hayoung610/Specilization3/labreport2_HayoungKim.pdf

JACOBS UNIVERSITY

# PCB design ECE Specialization Areas Lab Instructor: Uwe Pagel

## Hayoung Kim mailbox : KA-325

January 1, 2020

1

1 INTRODUCTION

In the lab, an insight of how an electronic device is actually designed was obtained. How the circuit is requested, specified, verified, PCB designed were studied by going through an example. The program LTspice, MATLAB were used to calculate and simulate the values of necessary components and to decide which components to use. Program KiCad was used to design the whole circuit. After deciding all the components and simulated, the PCB layout were set and designed.

2 REQUEST

Circuit which measures temperature and transmits the result as an I2C slave is required. Temperature range: −10o

to +50o
Voltage supply: 5V ±10% , USB, RS232 port
Accuracy: ±(5%r dg +4dg t)
Sample rate: 2Val/min
Stored history: Values last two hours
Environment: Resistance against condition inside normal office.
Other requirement such as weight, medium size, due date, costs needs to be considered.

3 SPECIFICATION

3.1 CIRCUIT DEFINITION

Circuit was divided into three functional blocks: Power, Analog, Digital Power : Power supply of +5V for analog and digital part
Analog : Sensor and Amplifier
Digital : Combined ADC and I2C

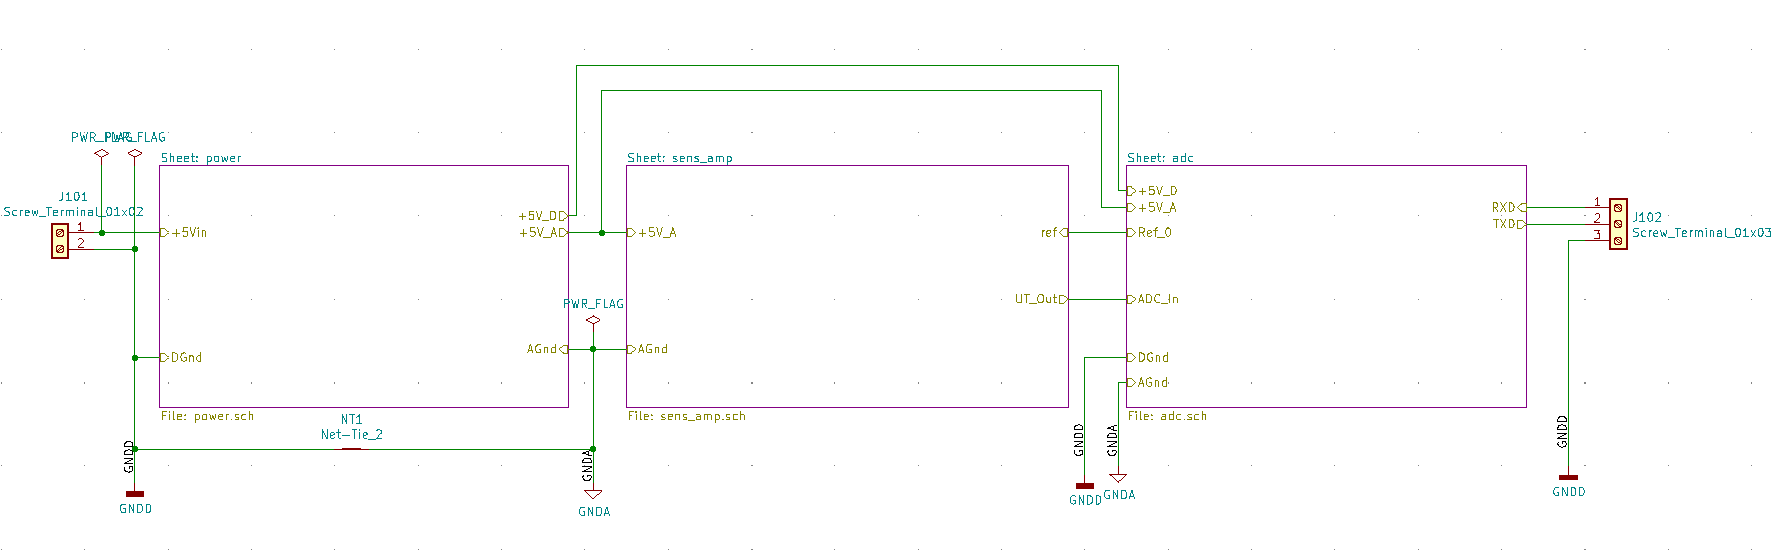
[picture p1: figure]

Figure 3.1: Circuit

2

3.2 DIGITAL PART

Digital part component : ADC, Timer, serial interface, memory
To contain all of the components, a micro controller is used. In the experiment, ATmega 328P was selected. ATmega328P includes 10 bit ADC. Which is enough to have one sample every 30 seconds(2Vals/min). However the error can be increased by 10 % but this is acceptable to reduce the cost.

The requested storage time says it has to store for two hours with sample rate of 2Val/min. With the calculation of 2Val/min*120min = 240 Vals need to be stored. Each values has 2 Bytes therefore total of 480bytes are needed. ATmega 328P has internal memory of 2048byte RAM that gives enough RAM for the program to run and store data.

The used micro controller has a reference voltage of 1.1V that can be used in the analog part for accurate measurement. In addition, it contains timer and RS232 interface. All the information of the micro controller can be checked in the datasheet of ATmega 328P. The digital part circuit is shown in figure 3.2.

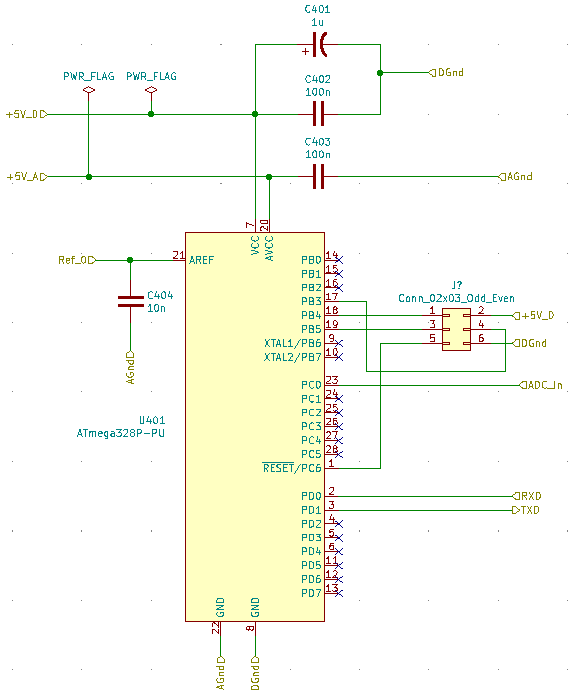
[picture p2: figure]

Figure 3.2: Digital part

3

3.3 ANALOG PART

Analog part components: Amplifiers, temperature sensor, reference voltage
The reference voltage comes from the micro controller from the digital part. This supply is too week because the output is less than 1mA. Therefore a non inverting amplifier is used. For the temperature sensor PT1000 is used in a Wheatstone bridge to sense the change in resistance. In addition, an instrumentation amplifier is used as a differential amplifier to amplify the output of the bridge circuit. The analog part circuit is shown in figure 3.3.

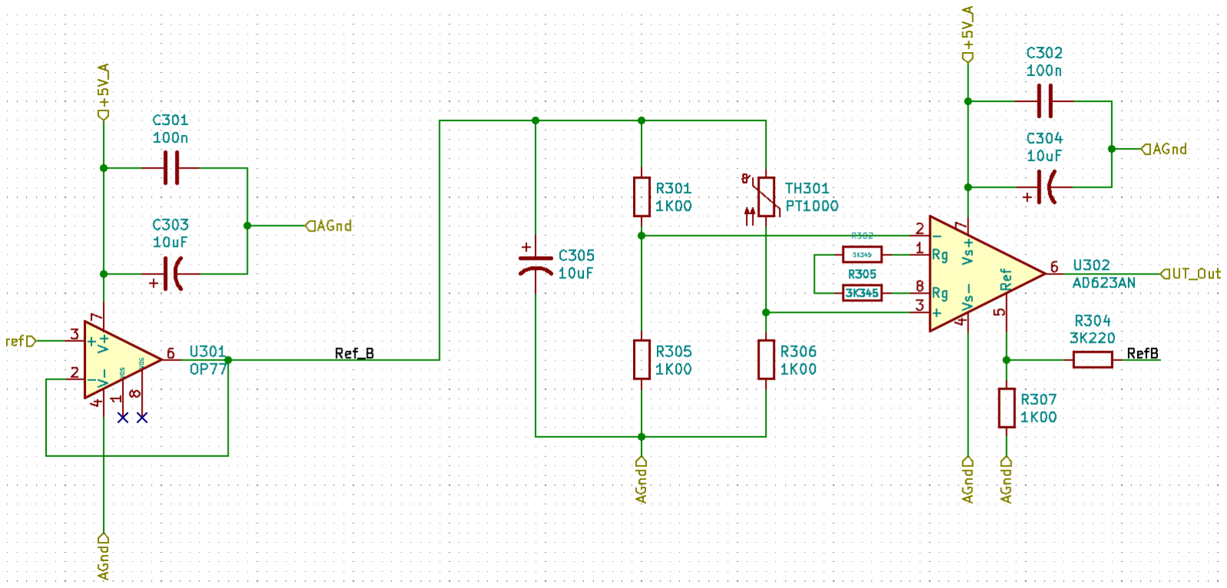
[picture p3: figure]

Figure 3.3: Analog part; Ref Vol Amp - Wheatstone PT1000 - Instrumentation Amp

3.4 POWER PART

In the power supply, 5V is requested as the supply voltage. To know the overall power usage, the overall usage of current needs to be known. The overall current is estimated as 13mA: micro controller needs up to 10mA, two amplifiers up to 1mA supply current, reference source about 2mA. The USB port can be used because it delivers up to 500mA and 5V ±10%. For the power, no converter or regulator is necessary because all the components can use to 5V. Also, the power supply is a RLC filter to reduce ripple from the source. The power circuit is shown in figure 3.4.

4

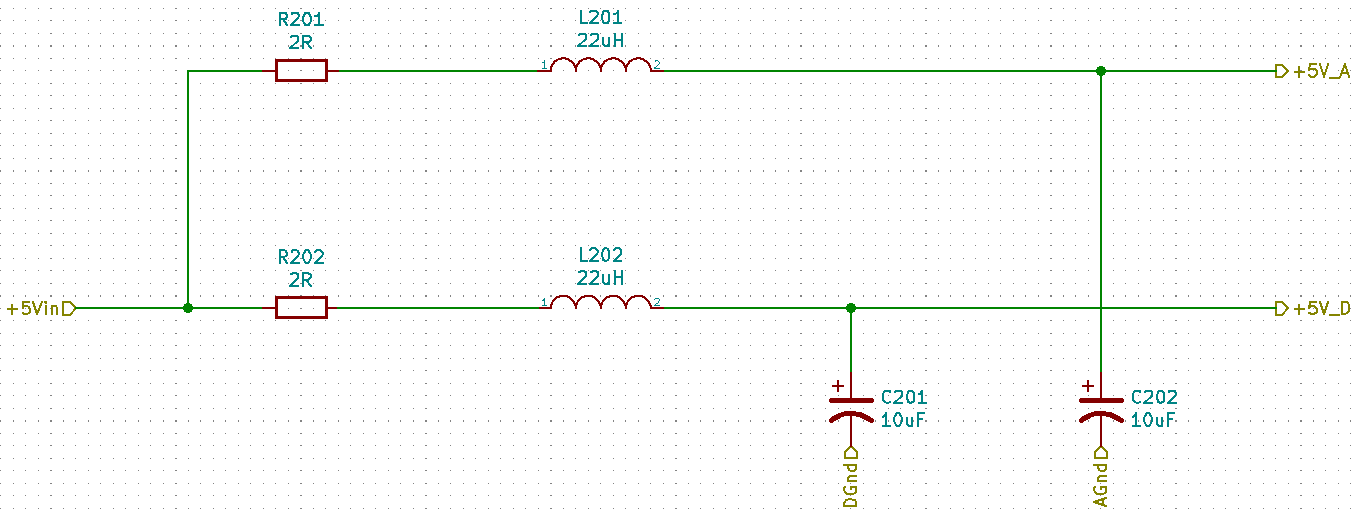
[picture p4: figure]

Figure 3.4: Power part

4 VERIFICATION

4.1 POWER PART

As explained before, the power part is a RLC filter. The filter has to work to suppress as much noise as possible in high frequency range. This is because ADC and differential amplifier in digital and analog part is sensitive to noise. LTspice is used here to figure out what type of capacitor and resistor is appropriate to suppress maximum amount of noise. The simulation circuit and result is sown in figure 4.1, 4.2.

Settings of LTspice simulation
frequency range: 10Hz - 1MHz
Inductor: Coilcraft DT3316P-223 with L = 22µH
Capacitor: C1- tantalum low ESR capacitor KEMET T521B106M016ATE100 with C = 10µF C2 - Al type Nichicon UPR1C100MAH with C = 10µF
Resistors were verified: 0.1Ω , 1Ω, 2Ω

In the figure 4.2, it can be seen that C1(tantalum) capacitor,marked in green, has steeper slope. It shows that C1 is better to uses since it suppress more noise and faster in high frequency range. The difference in damping is because of the change in resistor. In case of C1, when the resistor is small (0.1Ω) it shows a high overshoot. As the resistor becomes higher to 2Ω, the overshoot disappears. Therefore, C1 capacitor - Tantalum low ESR capacitor should be used and resistor with resistance of 2Ω would be the proper selection of the component.

5

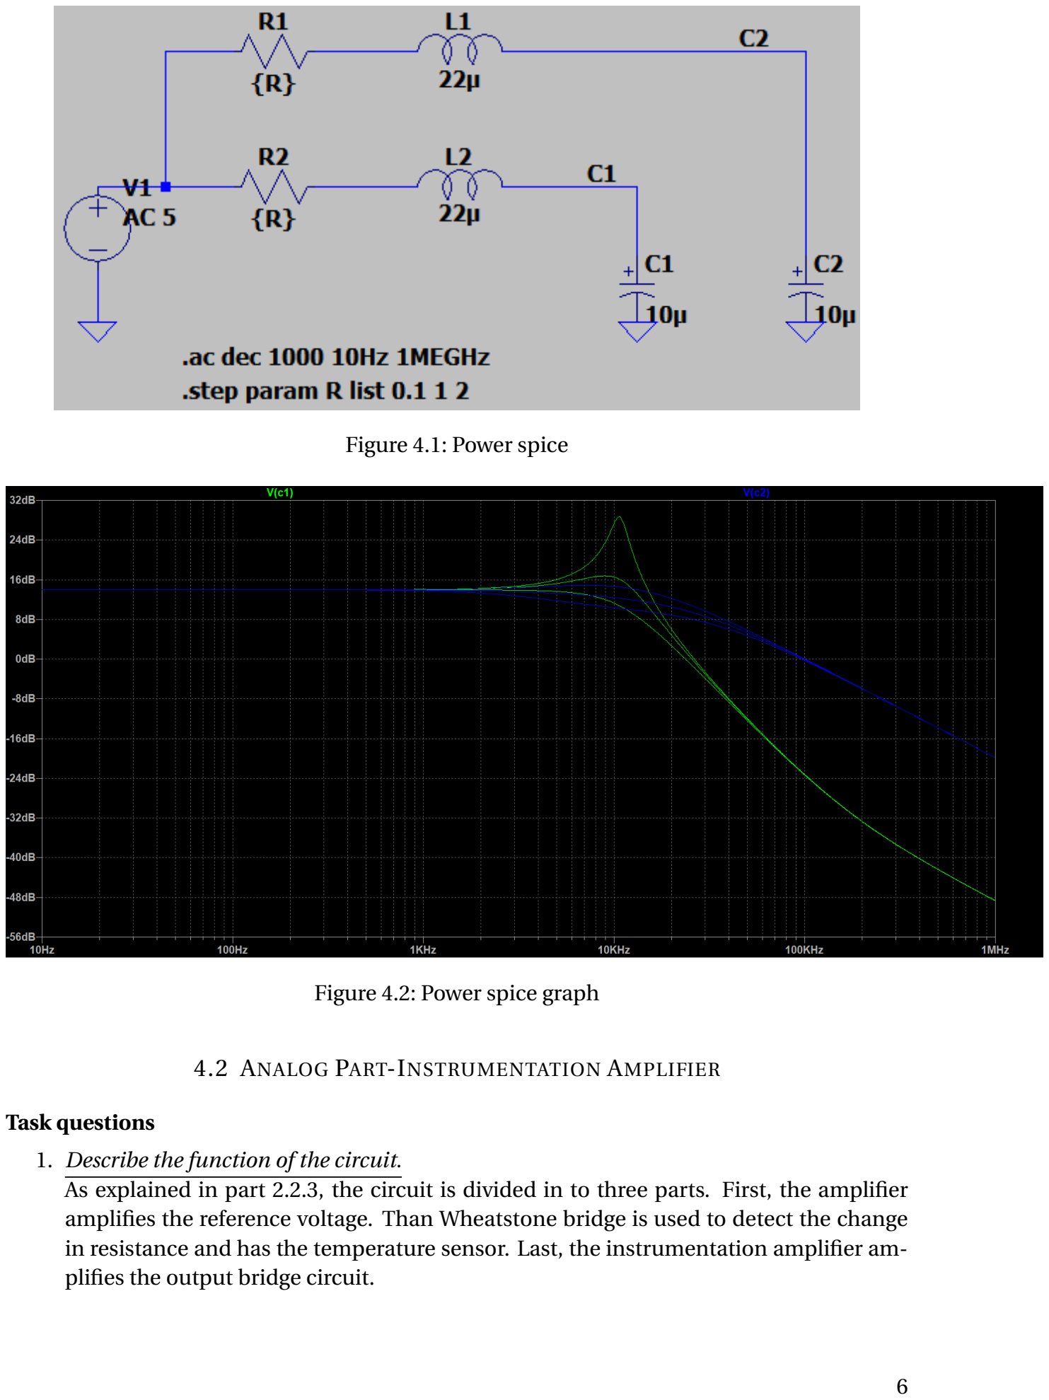
[picture p5: page 6]

Figure 4.1: Power spice

Figure 4.2: Power spice graph

4.2 ANALOG PART-INSTRUMENTATION AMPLIFIER

Task questions
1. Describe the function of the circuit.
As explained in part 2.2.3, the circuit is divided in to three parts. First, the amplifier amplifies the reference voltage. Than Wheatstone bridge is used to detect the change in resistance and has the temperature sensor. Last, the instrumentation amplifier amplifies the output bridge circuit.

6

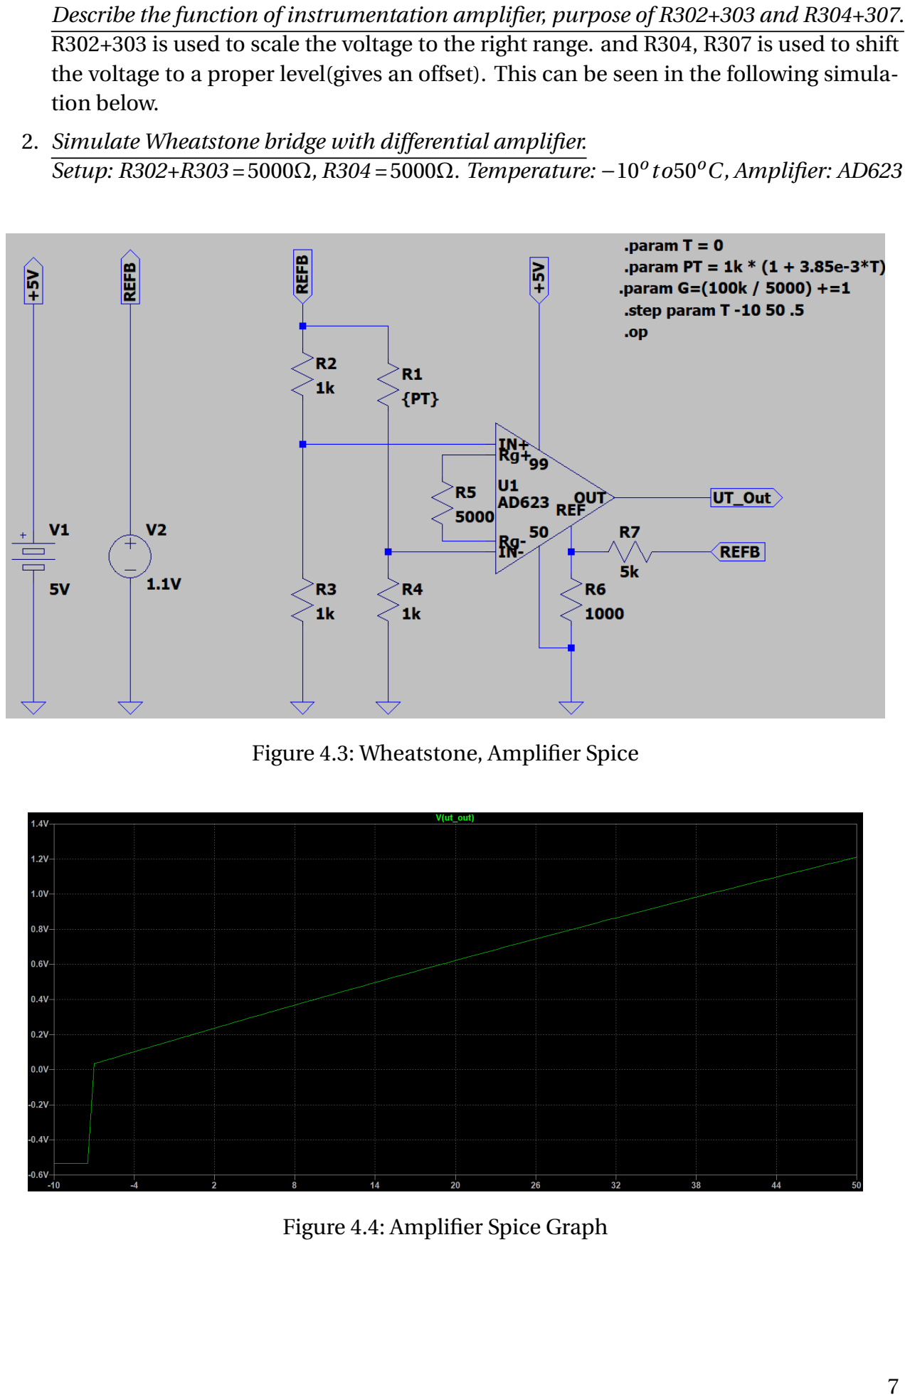
[picture p6: page 7]

Describe the function of instrumentation amplifier, purpose of R302+303 and R304+307. R302+303 is used to scale the voltage to the right range. and R304, R307 is used to shift the voltage to a proper level(gives an offset). This can be seen in the following simulation below.
2. Simulate Wheatstone bridge with differential amplifier.
Setup: R302+R303 = 5000Ω, R304 = 5000Ω. Temperature: −10o

to50oC, Amplifier: AD623

Figure 4.3: Wheatstone, Amplifier Spice

Figure 4.4: Amplifier Spice Graph

7

The simulation using LTspice is shown in figure 4.3, 4.4. As seen in figure 4.4, the result is a rising function with a jump in the beginning where the temperature is negative. This jump is caused when the input of the amplifier is negative. (When voltage difference between the positive input and the negative input of the amplifier is negative). The amplifier only works when it is uni polar. Hence it cannot amplify negative input signals. To fix this problem, an offset can be given by changing the ratio of R304 and R307. Also, R302+R303 is changed to provide proper scaling (gain) of the output.
3. Calculate values of Resistors to get proper gain and offset.
Temperature range: −10oC to50oC Output: 0V to1.1V

1 clc ; cl e a r a l l ; close a l l ;

2
3 | v _ r e f = 1 . 1 ; %re ference vol tage
4 | r = 1000; %r e si s t o r value r e f
5 | a = 3.85e−3; %tep c o e f fi ci e n t o f PT1000
6 | t_min = −15; %temperature min
7 | t_max = 55; | %temperature max
8 | t _p ts = −t_min + t_max + 1; | %points
9 | x = linspace (t_min , t_max , t _p ts ) ; %x axis , temperature
10 | r_p ts = r *

(1 + a *

x ) ; % r esis t anc e o f pt1000 over the temperatures

11

12
13 wheatV = ( ( r . / (2 *

r ) ) − ( r . / ( r + r_p ts ) ) ) * v _ r e f ; %Wheatstone bridge v ol t

14
15 %plo t ( x , wheatV)

16
17 | % sc alin g to 1.1 V
18 | gain = v _ r e f / (wheatV( t _p ts ) − wheatV( 1 ) ) ;
19 | r_gain = 100e3 / ( gain − 1 ) ; | %Gain from r e si s t o r

20
21 | % Used r esis t anc e and gain
22 | r_gain2 = round( r_gain / 10) * 10;
23 | gain2 = 100e3 / r_gain2 + 1;

24
25 | v _o f f = − wheatV( 1 ) * gain2 ; % o f f s e t
26 | r_304 = ( r * v _ r e f − r * v _o f f ) / v _o f f ; %R304
27 | v _o f f2 = r * v _ r e f / ( r + r_304 ) ; %Actual o f f s e t

28
29 fi x _ v ol t a g e = wheatV * gain2 + v _o f f ; %o f f s e t added to have only po si ti v e values

30
31 plo t ( x , fi x _ v ol t a g e ) ;

8

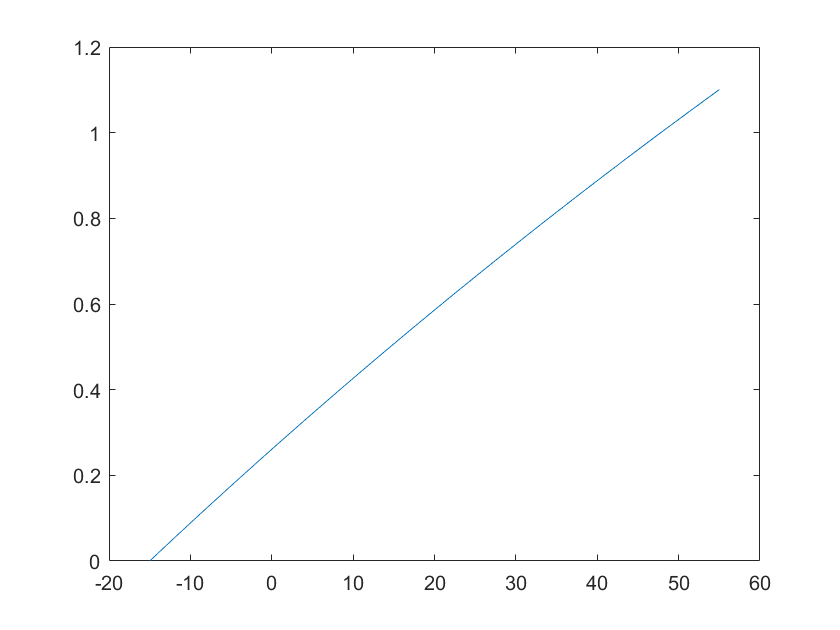
[picture p7: figure]

Figure 4.5: MATLAB graph

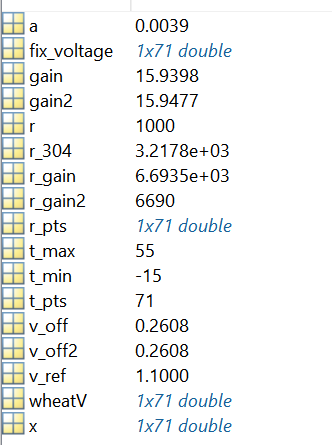
[picture p8: figure]

Figure 4.6: MATLAB value results

As seen above, a MATLAB simulation is done to calulate the value of resistors to give proper gain and offset to get a better amplifing output. As shown in figure 4.5, now the output is a steady rising function that goes from 0V to1.1V when the temperature is −10oC to 50oC.
In addition, shown in figure 4.6 the value of amplification and resistors were calculated. Amplification: 16.
R304 = 3217.8Ω (Later used 3220Ω)
Rgain = R302+R303 = 6690Ω | Therefore, R302, R303 was set to 3345Ω

9

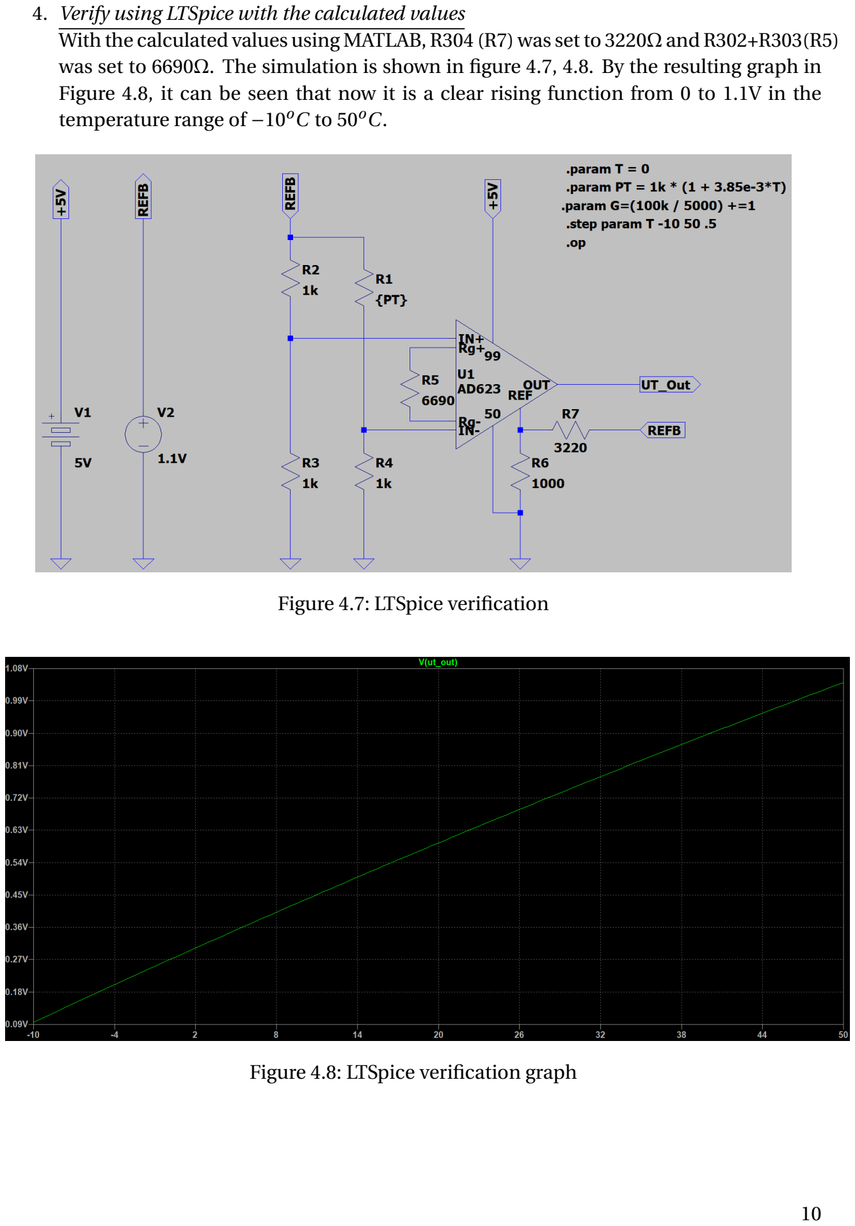
[picture p9: page 10]

4. Verify using LTSpice with the calculated values
With the calculated values using MATLAB, R304 (R7) was set to 3220Ω and R302+R303(R5) was set to 6690Ω. The simulation is shown in figure 4.7, 4.8. By the resulting graph in Figure 4.8, it can be seen that now it is a clear rising function from 0 to 1.1V in the temperature range of −10oC to 50oC.

Figure 4.7: LTSpice verification

Figure 4.8: LTSpice verification graph

10

5 ERROR ESTIMATION

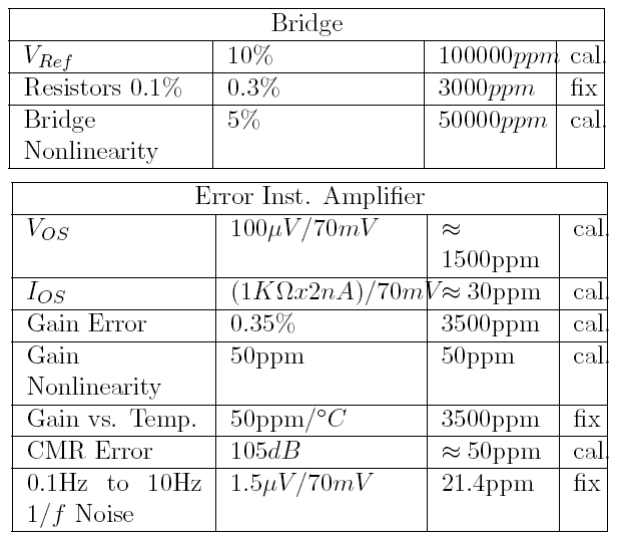
[picture p10: figure]

The table shows the error source of Wheatstone bridge and instrumentation amplifier. In the Wheatstone bridge, error regarding resistor can only be fixed by using better resistor and reference voltage error can be fixed by calibration. The output of wheatstone bridge is non linear. This is shown in figure5.1 comparing the result and the actual linear graph. More calibration and calculation is needed to reduce this non linearity.

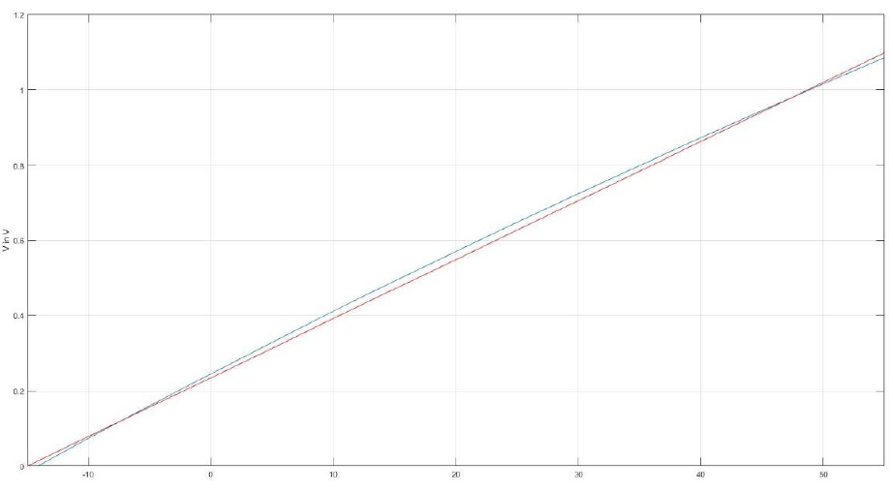
[picture p11: figure]

Figure 5.1: Linear error

11

In the instrumentation amplifier, gain, offset, linearity, CMR errors can be reduced by calibration. Also, selecting better resistors might improve errors too. Other errors such as gain non linearity and noise is hard to remove. These errors decrease the system resolution. In final, the total unadjusted error is estimated as 160000ppm while the resolution error is around 5000ppm.
In the analog part, the error can be reduced to 1% by calibration. The ADC adds 5 digits error. So around error of 0.350oC is included.
These errors can be reduced by using better components(Resistors, ADC, instrumentation amplifier, sensor..). Also, proper calibration will reduce error. After all the consideration, the right components should be selected. The components are all selected in KiCad and simulation was done to fix any errors in the circuit. The selected components are shown in figure5.2.

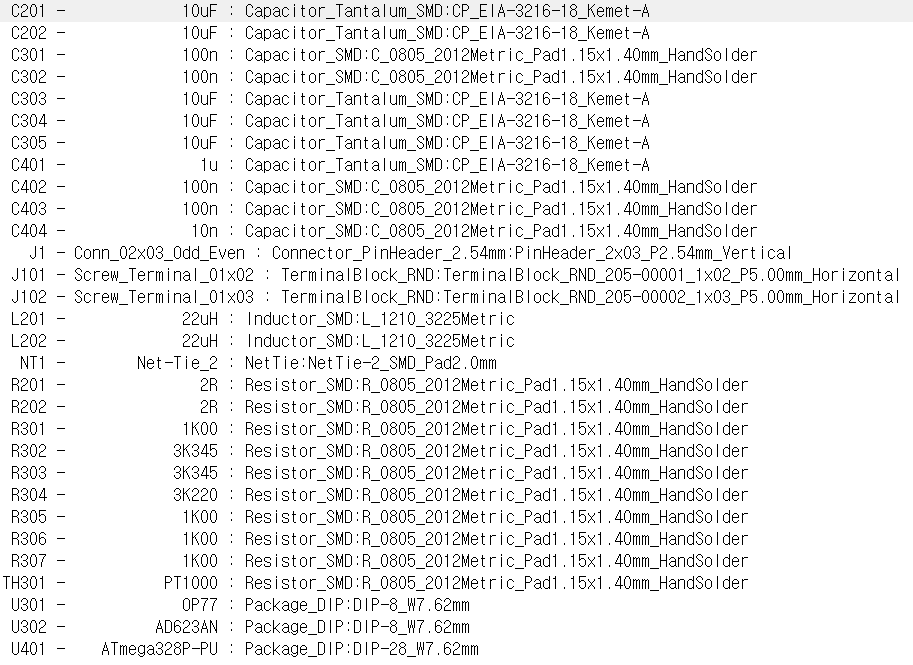
[picture p12: figure]

Figure 5.2: footprint

12

6 PCB DESIGN

After all the components are decided, PCB design can be processed. While doing PCB design, it is important to simplify the circuit as much as possible. Complicated connection in the circuit will end in a bad circuit board. Therefore it is important to place the components in a way to shorten and simplify(unscramble) the connection in between. Also, the right trace should be selected. Wider and longer the trace will give less resistance, giving higher currents
- with this trace, self heating has to be considered. Smaller traces are good to connect when going to a specific location on the board. Each traces can act as an inductor so it needs to be considered. It can disturb the circuit by giving mutual inductance. Also, loops in the circuit can act as a coil, giving inductance. To reduce this mutual inductance, loop areas should be kept as far as possible from each other. In addition, Two traces can act as a capacitor and store energy - giving stray capacitance. To remove this effect, a Faraday shield or Capacitive shield needs to be used.

The final PCB design is shown below.

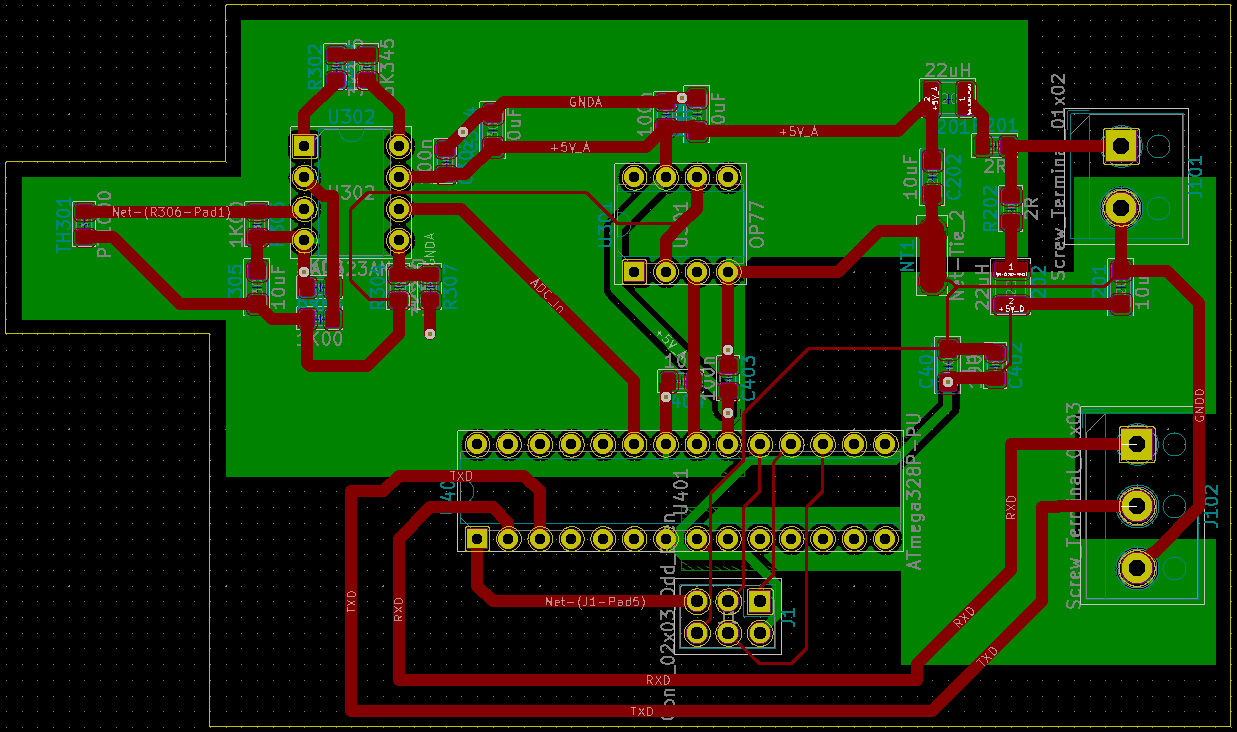
[picture p13: figure]

Figure 6.1: Complete PCB design

13

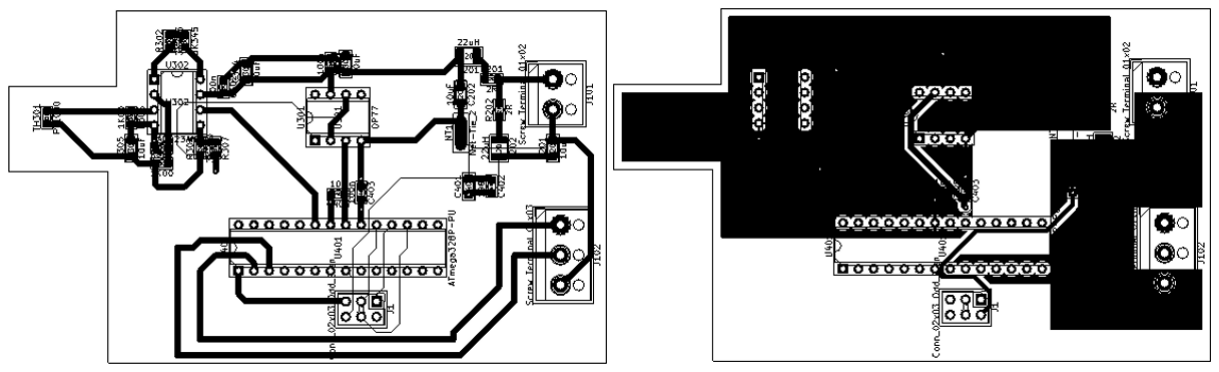
[picture p14: figure]

Figure 6.2: PCB upper and bottom layer

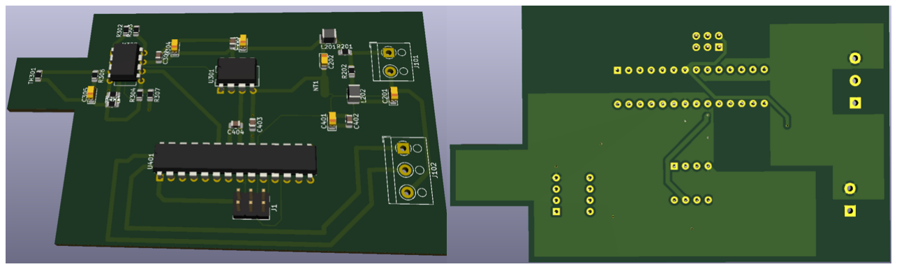
[picture p15: figure]

Figure 6.3: PCB 3D view

7 CONCLUSION

How the PCB design works were studied in the lab. Getting request, Specification, Simulation, Verification, estimating errors, designing circuit and PCB steps are all went through. Circuit that measures temperature and transmits the result are requested. According the given environment, the circuit was designed and simulated using MATLAB and LTspice to chose the right component. Than Kicad was used to design the circuit with the actual component. After selecting the right components and building the circuit, PCB design was done. The final circuit is shown in the section before. Some of the traces were too scrambled and messy. Also the components can be set in a better way to reduce disturbances. This can be improved by further experiences and studies.

Full schematic is included in the next pages.

14

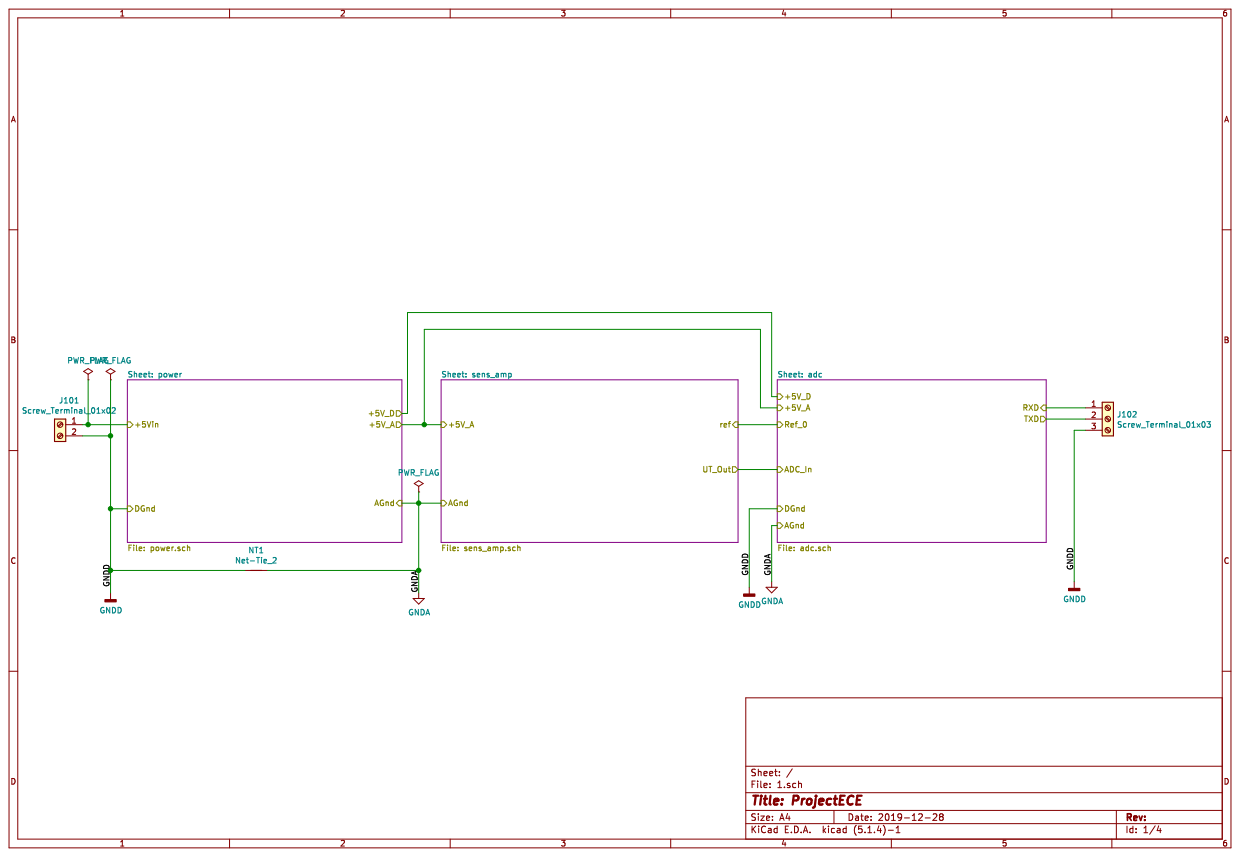
[picture p16: page 15]

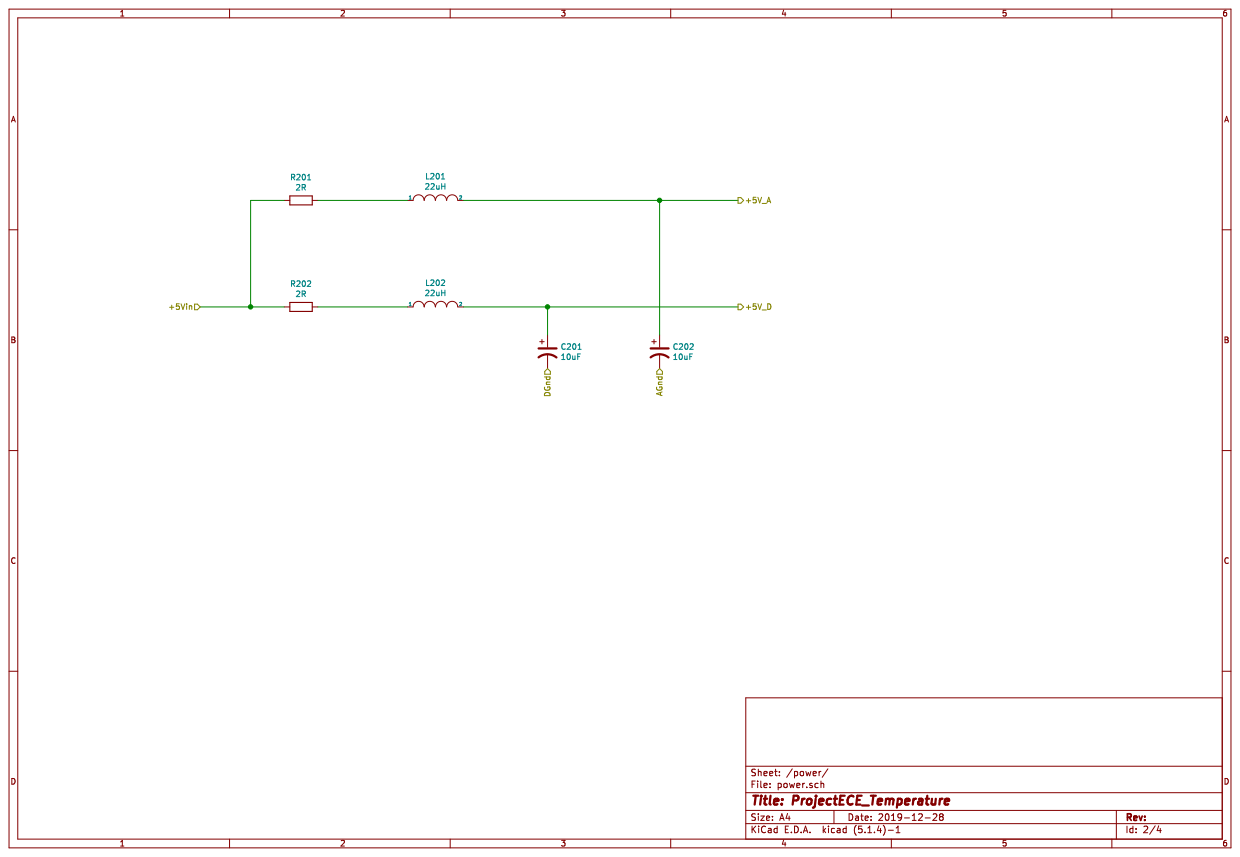
[picture p17: page 16]

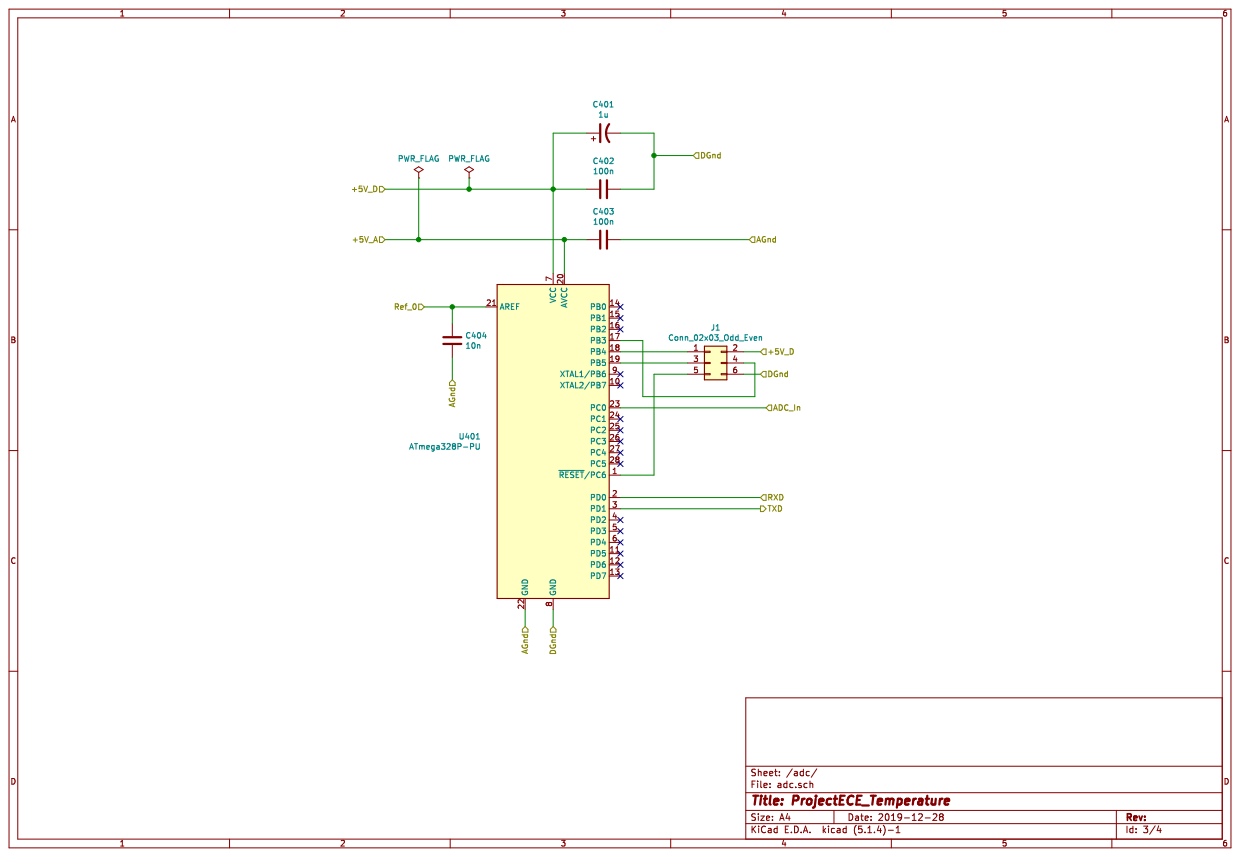
[picture p18: page 17]

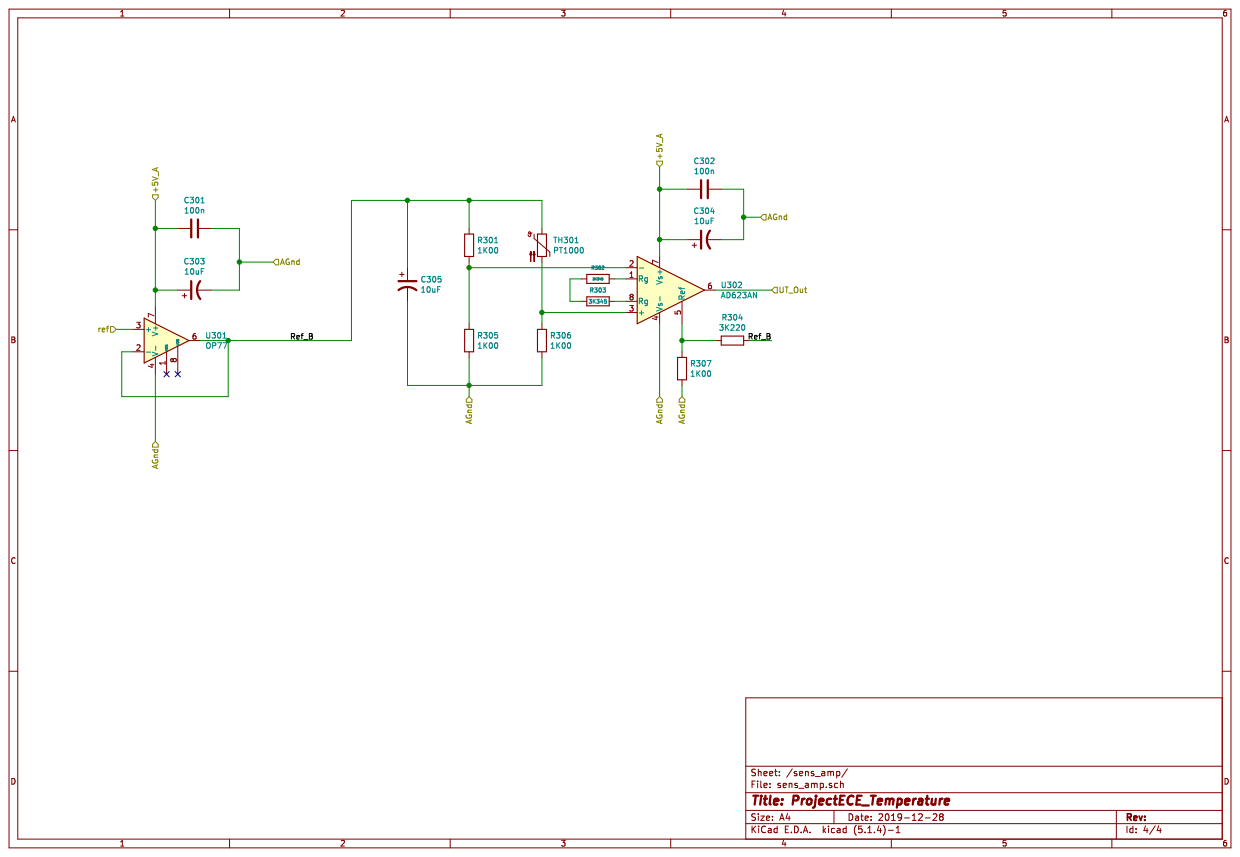
[picture p19: page 18]

8 REFERENCE

[1] Inst. Uwe Pagel: ’ECE Specialization Areas Lab’ (2019)
[2] Walt Keser, Bridge Circuits, http://www.faculty.jacobs-university.de/upagel/03.0.specarealab/03.1.addlit/bridge_notes_0.pdf
[3] Walter G.Jung, OP AMP APPLICATION,http://www.faculty.jacobs-university.de/upagel/03.0.specarealab/03.1.addlit/op_amp_analogdevices.pdf
[4] Circuit components datasheet:AD623, OP77, Atmega328p, PT1000,available in http://www.faculty.jacobs-university.de/upagel/03.0.specarealab/03.3.datasheet/index.html

19
