hayoung610/Specilization3/simulation/analog_amplifier_fix.asc

R1: res; {PT}
R2: res; 1k
R3: res; 1k
R4: res; 1k
R5: res; 5000
R6: res; 1000
R7: res; 5k
U1: ad623
V1: battery; 5V
V2: voltage; 1.1V
Named nets: 0, +5V, REFB, UT_Out
.param T = 0
.param PT = 1k * (1 + 3.85e-3*T)
.param G=(100k / 5000) +=1
.step param T -10 50 .5
.op
