hayoung610/Specilization3/simulation/ANALOG.asc

R1: res
R2: res
R3: res
R4: res
R5: res; 5000
R6: res
R7: res; 5000
U1: ad623
Named nets: 0
