hayoung610/Specilization3/simulation/analog_amplifier.asc

R1: res; {PT}
R2: res; 1k
R3: res; 1k
R4: res; 1k
R5: res; {RG}
R6: res; {Roff}
R7: res; 5k
U1: ad623
V1: battery; 5V
V2: voltage; 1.1V
Named nets: 0, +5V, VREF, UT_out
.param T = 0
.param PT = 1k * (1 + 3.85e-3*T)
.param RG = 5000
.param G = (100k / RG) + 1
.step param T -10 50 .5
.op
.step param Roff 1k 2k 100
