hayoung610/Specilization3/simulation/Draft2.asc

R1: res
R2: res
R3: res
R4: res
R5: res
R6: res
R7: res
