hayoung610/Specilization3/simulation/power.asc

C1: polcap; 10µ; V=16 Irms=1.12694 Rser=0.1 Lser=0 mfg="KEMET" pn="T521B106M016ATE100" type="Tantalum"
C2: polcap; 10µ; V=16 Irms=35m Rser=2.8 Lser=0 mfg="Nichicon" pn="UPR1C100MAH" type="Al electrolytic"
L1: ind; 22µ; Ipk=1 Rser=0.07224 Rpar=2072.4 Cpar=0 mfg="Coilcraft" pn="DT3316P-223"
L2: ind; 22µ; Ipk=1 Rser=0.07224 Rpar=2072.4 Cpar=0 mfg="Coilcraft" pn="DT3316P-223"
R1: res; {R}
R2: res; {R}
V1: voltage; ""; AC 5
Named nets: 0, C1, C2
.ac dec 1000 10Hz 1MEGHz
.step param R list 0.1 1 2
