hayoung610/Specilization3/kicad/1.kicad_pcb

## KiCad design kicad/1.kicad_pcb (2020-06-28)

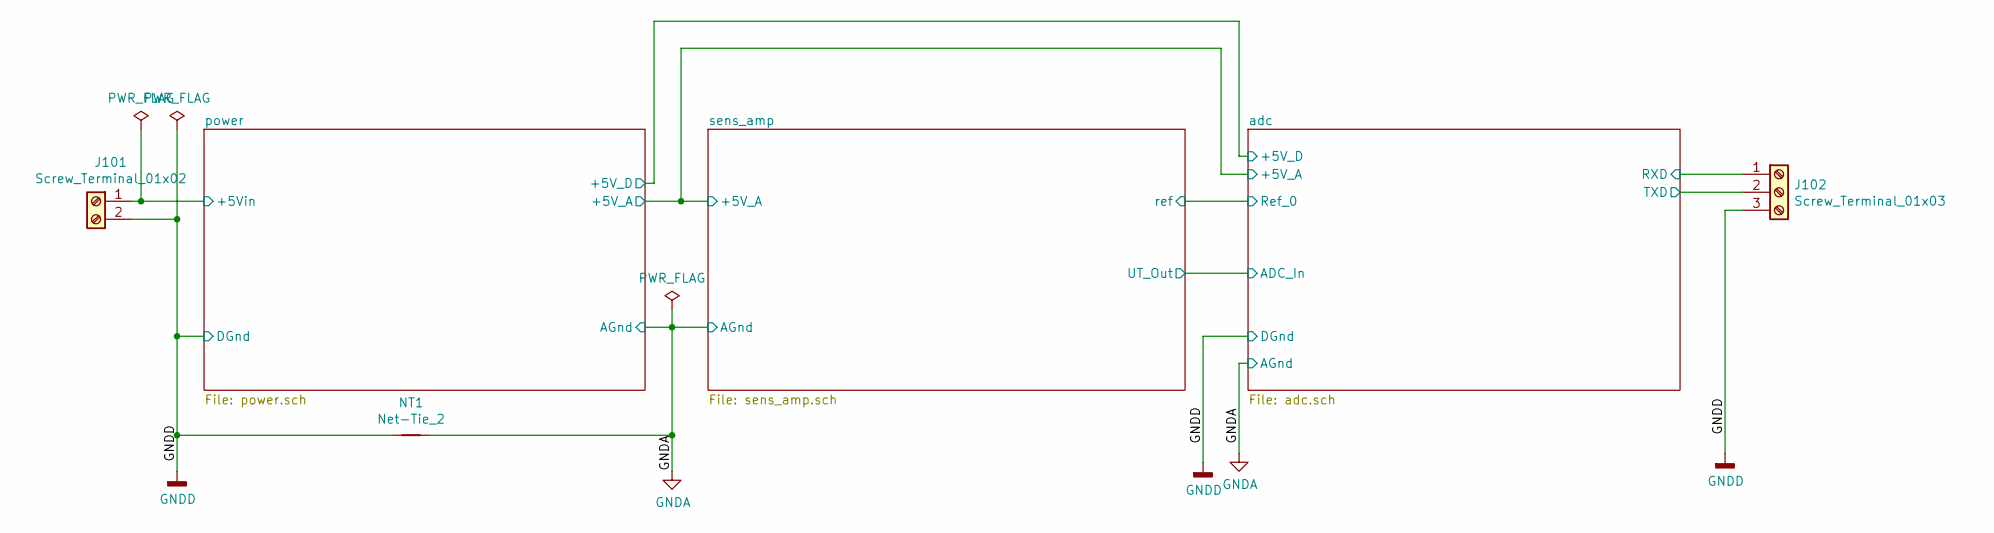
[picture p20: schematic 1.sch, ProjectECE]

Parts:
J101: Screw_Terminal_01x02; TerminalBlock_RND_205-00001_1x02_P5.00mm_Horizontal
J102: Screw_Terminal_01x03; TerminalBlock_RND_205-00002_1x03_P5.00mm_Horizontal
NT1: Net-Tie_2; NetTie-2_SMD_Pad2.0mm

Connections:
/adc/RXD: J102.1; also elsewhere on the board
/adc/TXD: J102.2; also elsewhere on the board
/power/+5Vin: J101.1; also elsewhere on the board
GNDA: NT1.2; also elsewhere on the board
GNDD: J101.2, J102.3, NT1.1; also elsewhere on the board

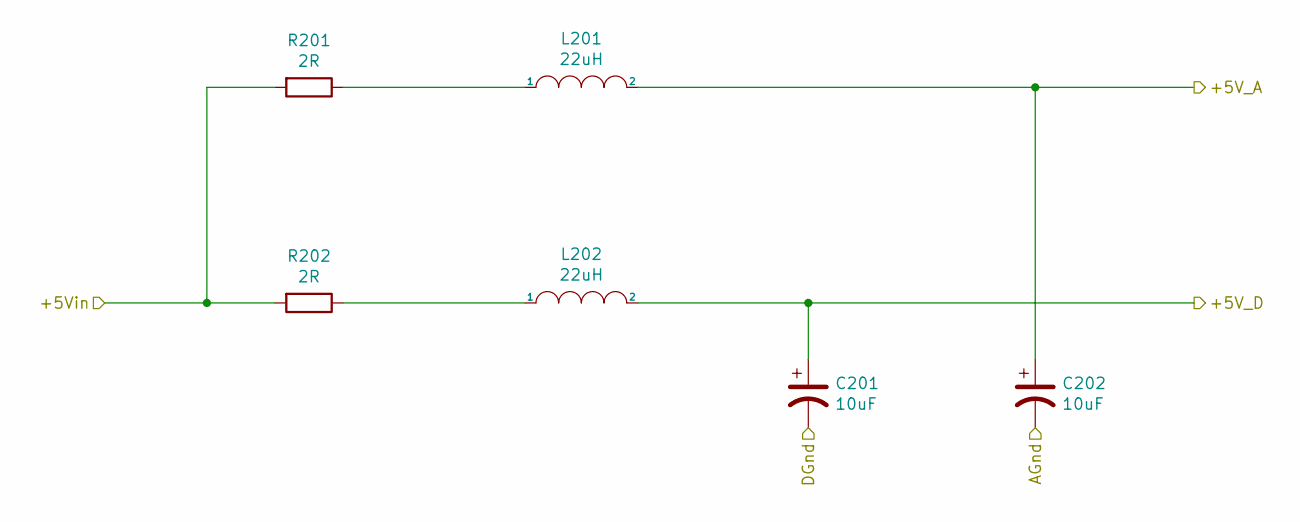
[picture p21: schematic power.sch, ProjectECE_Temperature]

Parts:
C201, C202: 10uF; CP_EIA-3216-18_Kemet-A
L201, L202: 22uH; L_1210_3225Metric
R201, R202: 2R; R_0805_2012Metric_Pad1.15x1.40mm_HandSolder

Connections:
/adc/+5V_A: C202.1, L201.2; also elsewhere on the board
/adc/+5V_D: C201.1, L202.2; also elsewhere on the board
/power/+5Vin: R201.2, R202.2; also elsewhere on the board
GNDA: C202.2; also elsewhere on the board
GNDD: C201.2; also elsewhere on the board
unnamed: L201.1, R201.1
unnamed: L202.1, R202.1

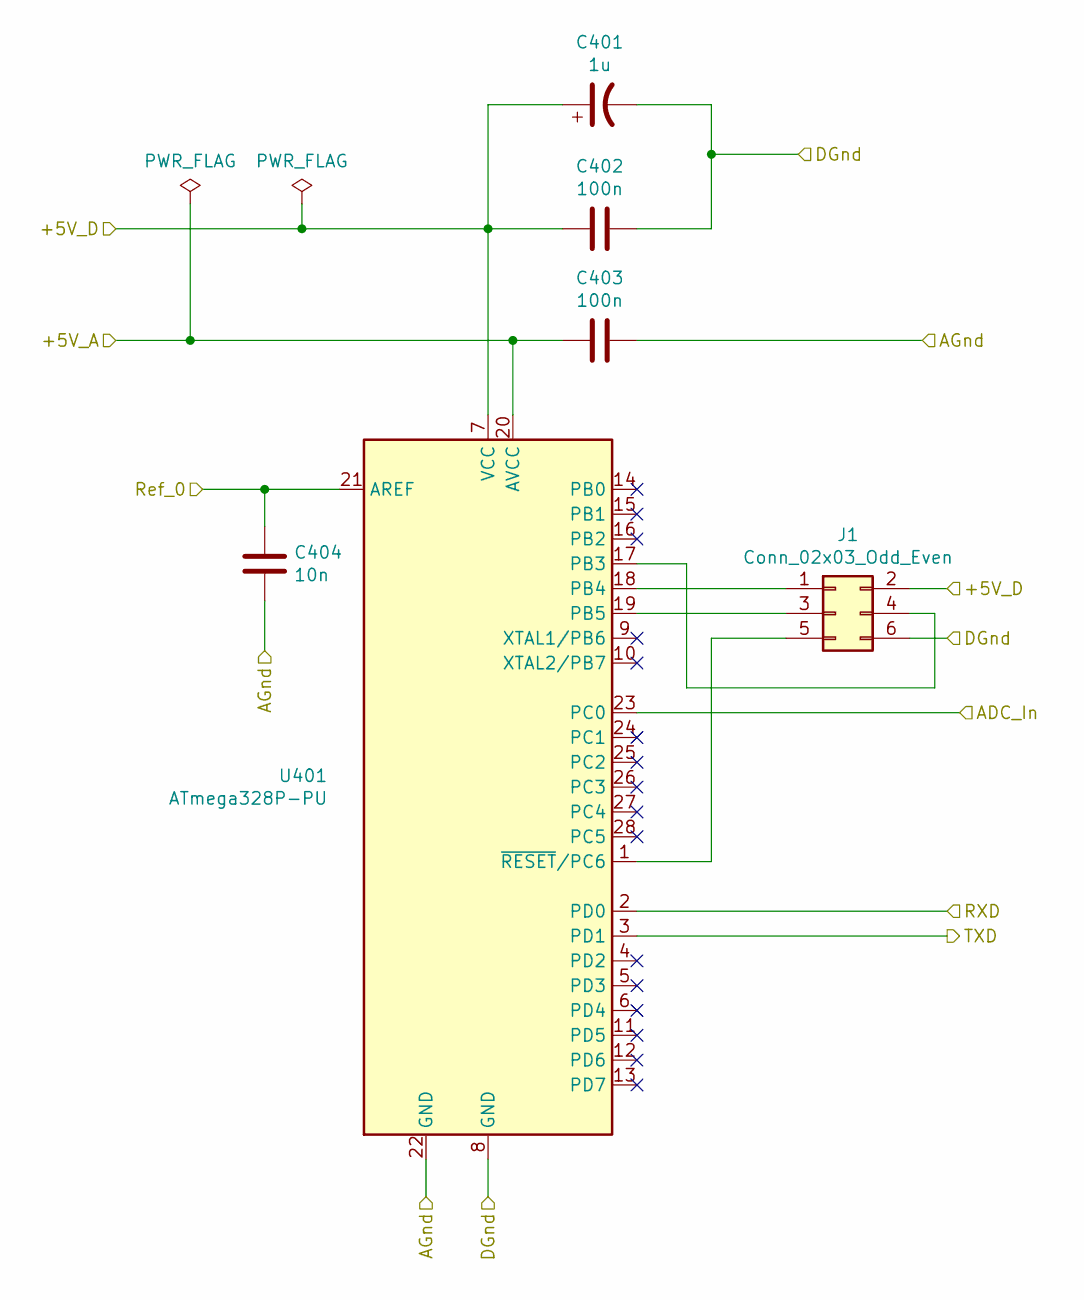
[picture p22: schematic adc.sch, ProjectECE_Temperature]

Parts:
C401: 1u; CP_EIA-3216-18_Kemet-A
C402, C403: 100n; C_0805_2012Metric_Pad1.15x1.40mm_HandSolder
C404: 10n; C_0805_2012Metric_Pad1.15x1.40mm_HandSolder
J1: Conn_02x03_Odd_Even; PinHeader_2x03_P2.54mm_Vertical
U401: ATmega328P-PU; DIP-28_W7.62mm

Connections:
/adc/+5V_A: C403.2, U401.20 (AVCC); also elsewhere on the board
/adc/+5V_D: C401.1, C402.2, J1.2, U401.7 (VCC); also elsewhere on the board
/adc/ADC_In: U401.23 (PC0); also elsewhere on the board
/adc/RXD: U401.2 (PD0); also elsewhere on the board
/adc/Ref_0: C404.1, U401.21 (AREF); also elsewhere on the board
/adc/TXD: U401.3 (PD1); also elsewhere on the board
GNDA: C403.1, C404.2, U401.22 (GND); also elsewhere on the board
GNDD: C401.2, C402.1, J1.6, U401.8 (GND); also elsewhere on the board
unnamed: J1.1, U401.18 (PB4)
unnamed: J1.3, U401.19 (PB5)
unnamed: J1.4, U401.17 (PB3)
unnamed: J1.5, U401.1 (~RESET~/PC6)

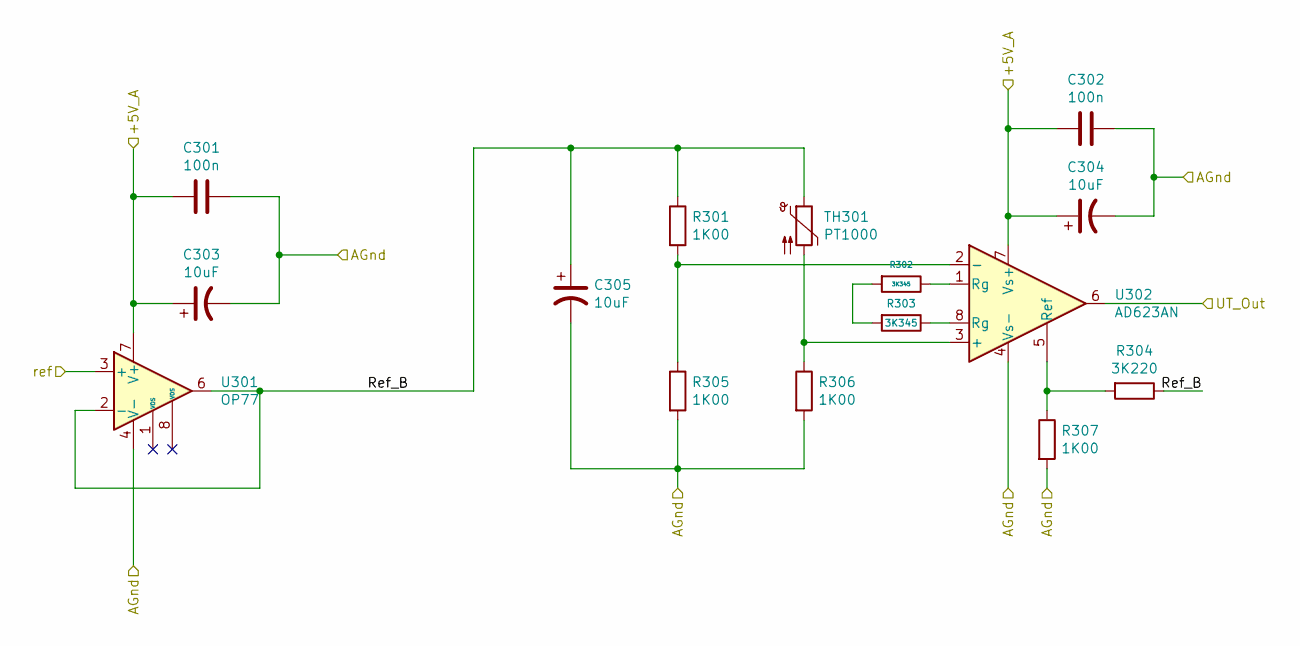
[picture p23: schematic sens_amp.sch, ProjectECE_Temperature]

Parts:
C301, C302: 100n; C_0805_2012Metric_Pad1.15x1.40mm_HandSolder
C303, C304, C305: 10uF; CP_EIA-3216-18_Kemet-A
R301, R305, R306, R307: 1K00; R_0805_2012Metric_Pad1.15x1.40mm_HandSolder
R302, R303: 3K345; R_0805_2012Metric_Pad1.15x1.40mm_HandSolder
R304: 3K220; R_0805_2012Metric_Pad1.15x1.40mm_HandSolder
TH301: PT1000; R_0805_2012Metric_Pad1.15x1.40mm_HandSolder
U301: OP77; DIP-8_W7.62mm
U302: AD623AN; DIP-8_W7.62mm

Connections:
/adc/+5V_A: C301.2, C302.2, C303.1, C304.1, U301.7 (V+), U302.7 (Vs+); also elsewhere on the board
/adc/ADC_In: U302.6; also elsewhere on the board
/adc/Ref_0: U301.3 (+); also elsewhere on the board
/sens_amp/Ref_B: C305.1, R301.1, R304.1, TH301.1, U301.2 (-), U301.6
GNDA: C301.1, C302.1, C303.2, C304.2, C305.2, R305.2, R306.2, R307.2, U301.4 (V-), U302.4 (Vs-); also elsewhere on the board
unnamed: R301.2, R305.1, U302.2 (-)
unnamed: R302.1, U302.1 (Rg)
unnamed: R302.2, R303.2
unnamed: R303.1, U302.8 (Rg)
unnamed: R304.2, R307.1, U302.5 (Ref)
unnamed: R306.1, TH301.2, U302.3 (+)

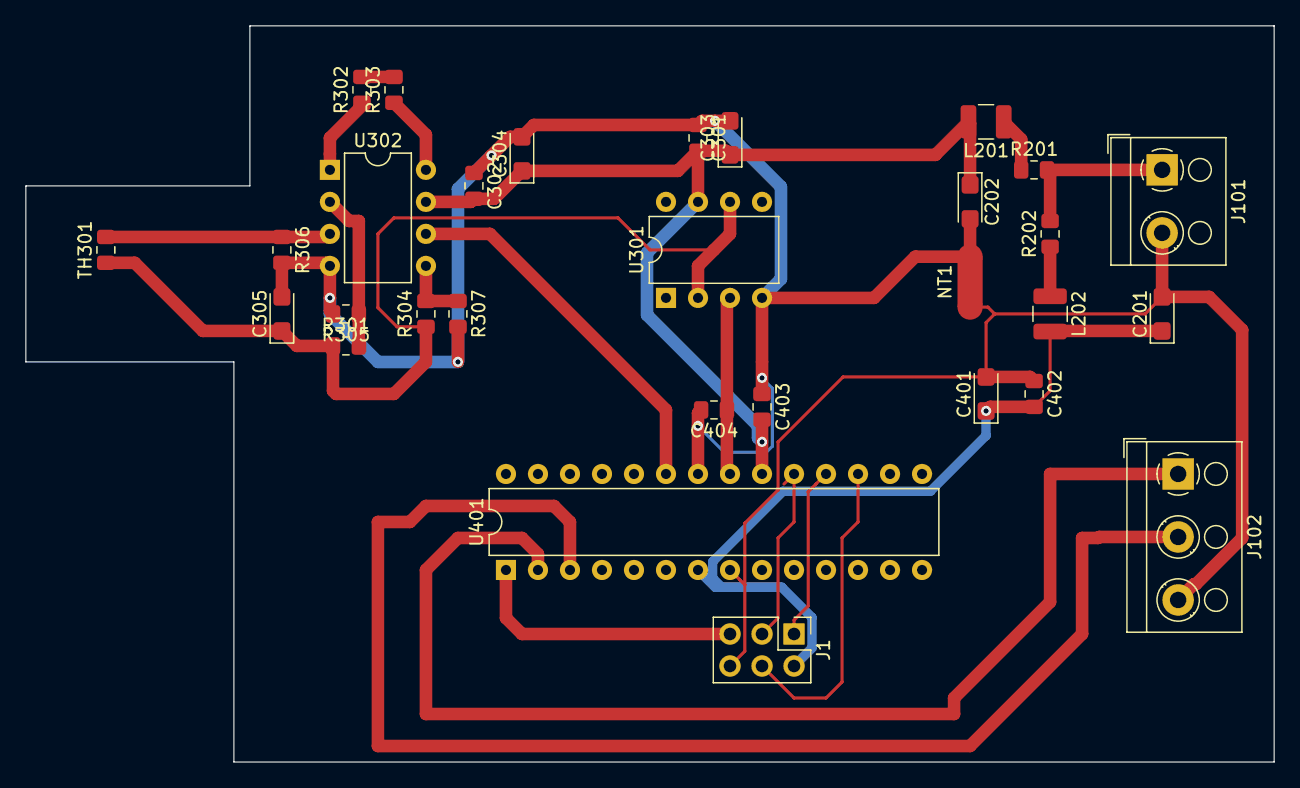
[picture p24: board 1.kicad_pcb from above]

Board: 2 copper layers, 99.1 x 58.4 mm, 30 parts (0 on the bottom side), 22 nets.
